msieverding/gondola_arduino/esp8266_pcb/gondola.brd

## EAGLE design esp8266_pcb/gondola.brd (2017-10-06)

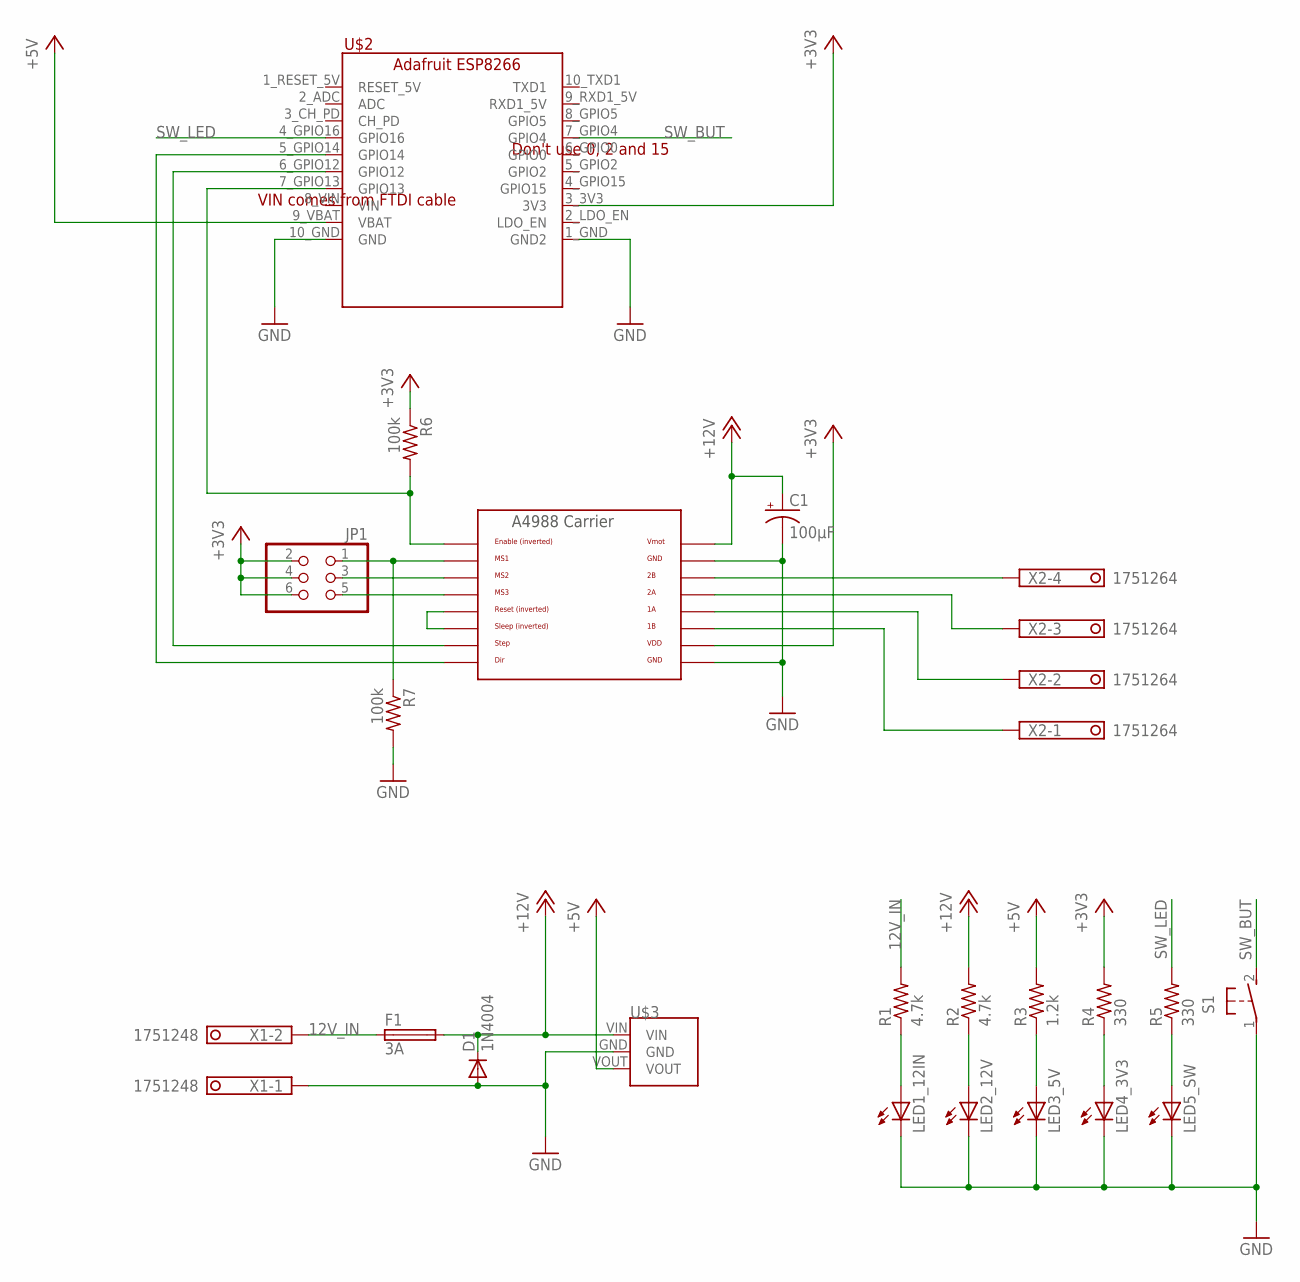
[picture p2: schematic gondola.sch]

Parts:
C1: 100µF; 153CLV-0605
D1: 1N4004; DO41-10
F1: 3A; LITTLEFUSE
JP1: PINHD-2X3; 2X03
LED1_12IN, LED2_12V, LED3_5V, LED4_3V3, LED5_SW: LEDCHIP-LED0805; CHIP-LED0805
R1, R2: 4.7k; R0805
R3: 1.2k; R0805
R4, R5: 330; R0805
R6, R7: 100k; R0805
S1: 31-XX; B3F-31XX
U$1: A4988BREAKOUT
U$2: ADAFRUIT_ESP8266
U$3: ROHM_BP5293-XX
X1: 1751248
X2: 1751264

Connections:
1A: U$1.1A, X2.2
1B: U$1.1B, X2.1
2A: U$1.2A, X2.3
2B: U$1.2B, X2.4
12V_IN: F1.1, R1.2, X1.2
!RESET: U$1.RST, U$1.SLP (SLEEP)
+3V3: JP1.2, JP1.4, JP1.6, R4.2, R6.1, U$1.VDD, U$2.3_3V3 (3V3)
+5V: R3.2, U$2.9_VBAT (VBAT), U$3.VOUT
+12V: C1.+, D1.C, F1.2, R2.2, U$1.VMOT, U$3.VIN
DIR: U$1.DIR, U$2.5_GPIO14 (GPIO14)
GND: C1.-, D1.A, LED1_12IN.C, LED2_12V.C, LED3_5V.C, LED4_3V3.C, LED5_SW.C, R7.2, S1.1, U$1.GND, U$1.GND@0 (GND), U$2.1_GND (GND2), U$2.10_GND (GND), U$3.GND, X1.1
MS1: JP1.1, R7.1, U$1.MS1
MS2: JP1.3, U$1.MS2
MS3: JP1.5, U$1.MS3
M_EN: R6.2, U$1.EN, U$2.7_GPIO13 (GPIO13)
unnamed: LED2_12V.A, R2.1
unnamed: LED1_12IN.A, R1.1
unnamed: LED4_3V3.A, R4.1
unnamed: LED5_SW.A, R5.1
unnamed: LED3_5V.A, R3.1
STEP: U$1.STEP, U$2.6_GPIO12 (GPIO12)
SW_BUT: S1.2 (S), U$2.7_GPIO4 (GPIO4)
SW_LED: R5.2, U$2.4_GPIO16 (GPIO16)

Notes on the sheet:
Don't use 0, 2 and 15
VIN comes from FTDI cable

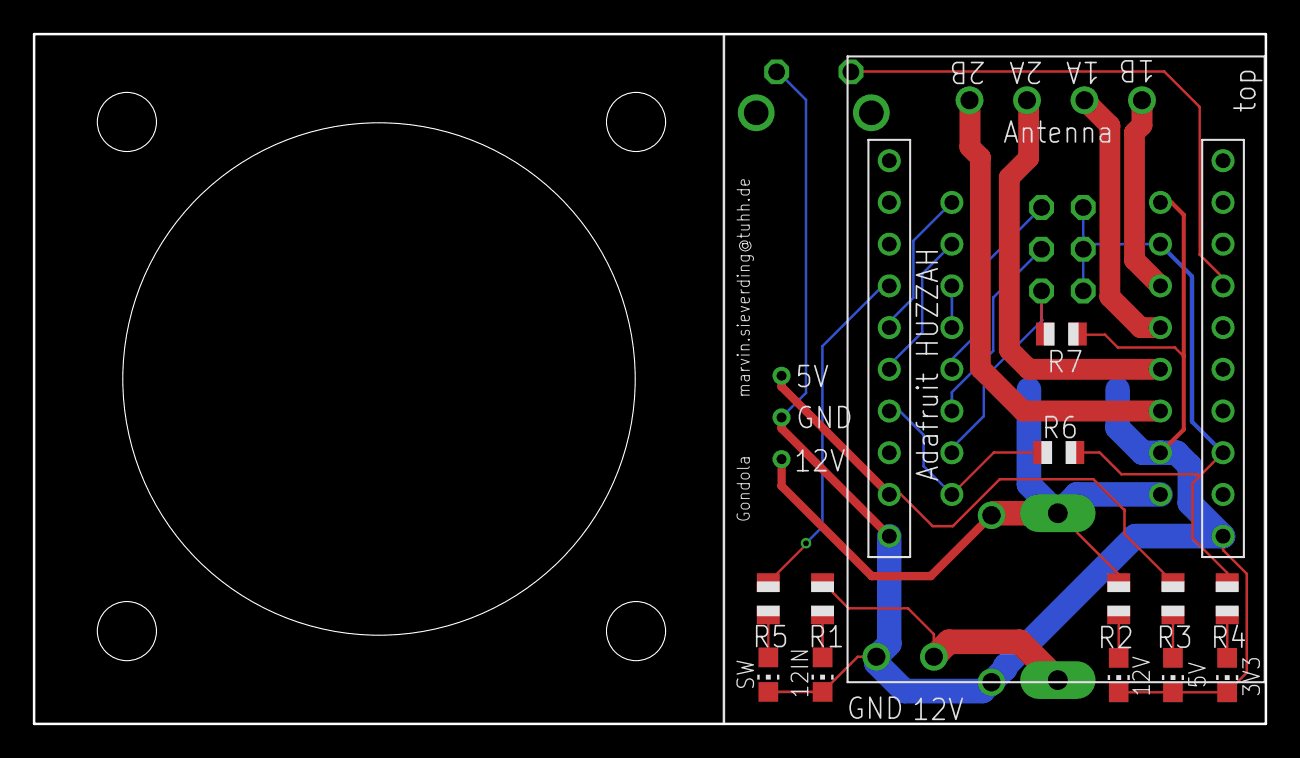
[picture p3: board gondola.brd from above]

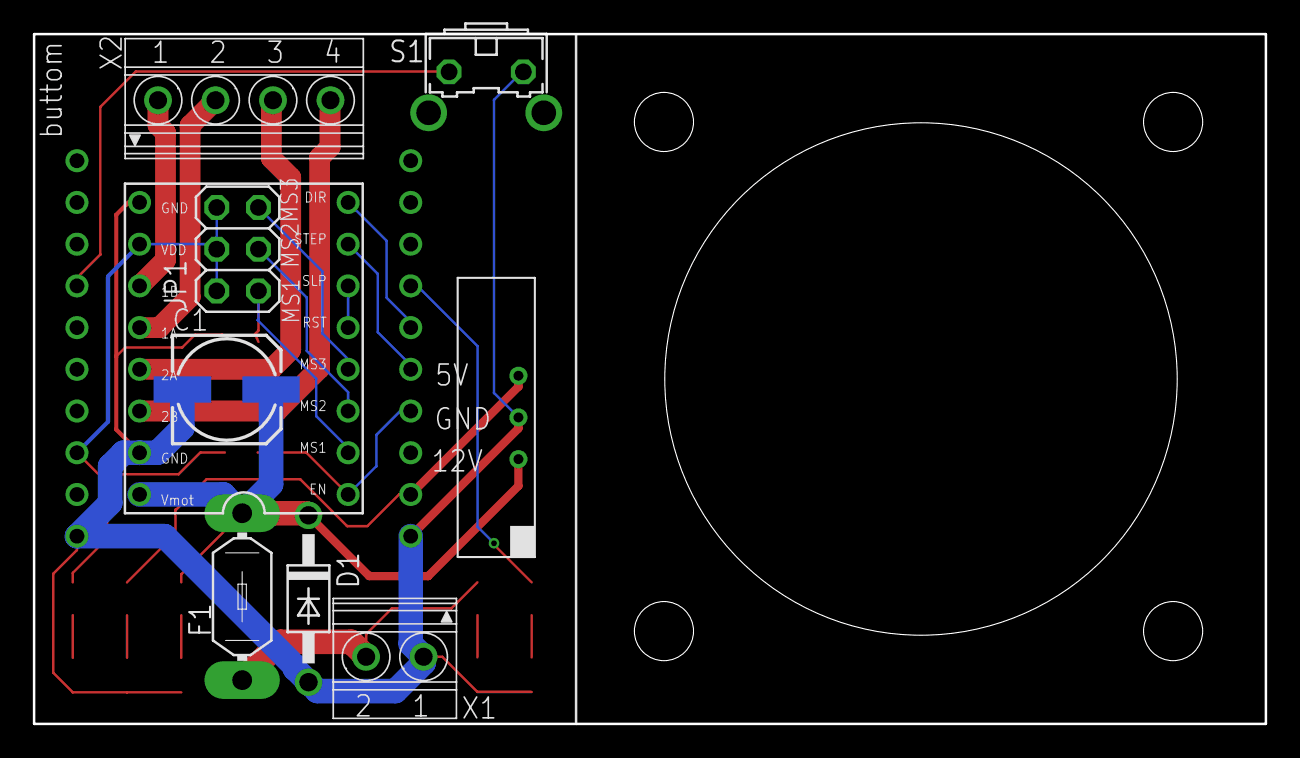
[picture p4: board gondola.brd from below]

Board: 2 copper layers, 75.0 x 42.0 mm, 22 parts (9 on the bottom side), 23 nets.
