msieverding/gondola_arduino/arduino_controller/todo.txt

gondola as singleton
Coordinate member private
