msieverding/gondola_arduino/(commit log)

2017-08-08 fixed bug in lists + destructors
    [esp8266_controller.ino]
2017-08-09 fixed bugs in serial readout and some nice functions for commandInterpreter
    [esp8266_controller.ino]
2017-08-09 some layout of serial printout
2017-08-21 Update README.md
    Changed from arduino to esp8266
2017-09-04 [WiFiConnection]Set Hostname before WiFi.begin() for correct DNS entries
    [esp8266_controller.ino]
2017-09-05 [APConnection] Fixed bug that APConnecton deos not work
    DNSServer of APConnection was not handled and this disturbed the access point
    [esp8266_controller.ino]
2017-09-08 [Framework] Framework improvements
2017-09-08 [Config] Print config on startup when log level is at least LOG_DEBUG
2017-09-11 [Framework] + [MqTT]implemented moveCommand with strings due to missing binary support of MqTT broker library
2017-09-18 [Anchor] Fixed bug, that motor made one step too much
2017-09-22 [WebSocket] Asynchronous web sockets with compiler flag
2017-09-27 added eagle files of PCB
    [gondola.brd, gondola.sch]
2017-10-06 some work on pcb
    [gondola.brd, gondola.sch]
